trychlos/mysGarageDoors/build/mysGarageDoors.ods

Sheet: Nano
 |  |  | Digital | Analog |  | MySensors | NRF24L01 |  | Door n° 1 | Door n° 2
1 | TX | Reserved UART |  |  | PCINT2 Port D
2 | RX | Reserved UART
3 | RST
4 | GND |  |  |  |  |  | 1 | GND
5 | D2 / IRQ0 |  |  |  |  |  | 5 | IRQ | Opening move
6 | D3 / IRQ1 |  | √ |  |  |  |  |  | Closing move
7 | D4 |  | √ |  |  |  |  |  | Closed contact
8 | D5 |  | √ |  |  |  |  |  | Open/close button
9 | D6 |  | √ |  |  |  |  |  | Enabled
10 | D7 |  | √ |  |  | MY_RANDOMSEED_PIN
11 | D8 |  | √ |  | PCINT0 Port B
12 | D9 |  |  |  |  |  | 2 | CE
13 | D10 |  |  |  |  |  | 7 | CSN
14 | D11 |  |  |  |  |  | 6 | MOSI
15 | D12 |  |  |  |  |  | 4 | MISO
16 | D13 |  |  |  |  |  | 3 | SCK
17 | 3V3 |  |  |  |  |  | 8 | VCC
18 | AREF
19 | A0 |  | √ | √ | PCINT1 Port C |  |  |  | Learning program
20 | A1 |  | √ | √ |  |  |  |  |  | Enabled
21 | A2 |  | √ | √ |  |  |  |  |  | Open/close button
22 | A3 |  | √ | √ |  |  |  |  |  | Closed contact
23 | A4 |  | √ | √ |  |  |  |  |  | Closing move
24 | A5 |  | √ | √ |  |  |  |  |  | Opening move
25 | A6 |  |  | √
26 | A7 |  |  | √
27 | +5V
28 | RST
29 | GND
30 | VIN

Sheet: MySensors
Arduino sensor |  |  |  |  |  | mySensor event
Sens | Name | Id | Type | Comment | pwiSensor | Nature | Command | Message | Payload | Comment
In | CHILD_MAIN | 1 | S_CUSTOM | Main target |  | Action | C_REQ | V_CUSTOM | 1 | EEPROM reset
In | CHILD_MAIN | 1 | S_CUSTOM | Main target |  | Action | C_REQ | V_CUSTOM | 2 | Full configuration dump
In | CHILD_MAIN | 1 | S_CUSTOM | Main target |  | Action | C_REQ | V_CUSTOM | 3 | Run learning program
In | CHILD_MAIN+1 | 2 | S_CUSTOM | Main target |  | Action | C_SET | V_CUSTOM | <ms> | Set unchanged timeout (ms) ; default=3600000 (1h)
Out | CHILD_MAIN+1 | 2 | S_CUSTOM | Main target |  | Info |  | V_VAR1 | <ms> | Unchanged timeout
In | CHILD_MAIN+2 | 3 | S_CUSTOM | Main target |  | Action | C_SET | V_CUSTOM | <ms> | Set the reaction time of the sensors ; default=250ms
Out | CHILD_MAIN+2 | 3 | S_CUSTOM | Main target |  | Info |  | V_VAR1 | <ms> | Reaction time
In | CHILD_MAIN+3 | 4 | S_CUSTOM | Main target |  | Action | C_SET | V_CUSTOM | <ms> | Set the learning delay between open/close moves ; default=5000 (5s)
Out | CHILD_MAIN+3 | 4 | S_CUSTOM | Main target |  | Info |  | V_VAR1 | <ms> | Learning open/close delay
In | CHILD_MAIN+4 | 5 | S_CUSTOM | Main target |  | Action | C_SET | V_CUSTOM | <ms> | Set the learning delay each door moves ; default=5000 (5s)
Out | CHILD_MAIN+4 | 5 | S_CUSTOM | Main target |  | Info |  | V_VAR1 | <ms> | Learning inter-doors delay
In | CHILD_MAIN+5 | 6 | S_CUSTOM | Main target |  | Action | C_SET | V_CUSTOM | <ms> | Set the move debounce delay ; default=1000 (1s)
Out | CHILD_MAIN+5 | 6 | S_CUSTOM | Main target |  | Info |  | V_VAR1 | <ms> | Move debounce delay
In | CHILD_MAIN+6 | 7 | S_CUSTOM | Main target |  | Action | C_SET | V_CUSTOM | <ms> | Set the button push delay ; default=500ms
Out | CHILD_MAIN+6 | 7 | S_CUSTOM | Main target |  | Info |  | V_VAR1 | <ms> | Button push delay
In | CHILD_MAIN+7 | 8 | S_CUSTOM | Main target |  | Action | C_SET | V_CUSTOM | % | Set the minimal change to be published ; default=10%
Out | CHILD_MAIN+7 | 8 | S_CUSTOM | Main target |  | Info |  | V_VAR1 | % | Min published change
In | CHILD_ID_DOOR1 | 20 | S_DOOR |  |  | Action | C_REQ | V_CUSTOM | 1 | Open/close the door
Out | CHILD_ID_DOOR1 | 20 | S_DOOR |  |  | Info |  | V_VAR1 | 1|0 | Whether the door is enabled
Out | CHILD_ID_DOOR1+1 | 21 | S_DOOR |  |  | Info |  | V_UP | % | Whether the door is opening ; payload is position
Out | CHILD_ID_DOOR1+1 | 21 | S_DOOR |  |  | Info |  | V_DOWN | % | Whether the door is closing ; payload is position
Out | CHILD_ID_DOOR1+2 | 22 | S_DOOR |  |  | Info |  | V_PERCENTAGE | % | Door position (0=closed, 100=opened) – not sent during the move
Out | CHILD_ID_DOOR1+3 | 23 | S_DOOR |  |  | Info |  | V_VAR1 | 1|0 | 1 if door is fully closed (from the contact)
Out | CHILD_ID_DOOR1+4 | 24 | S_DOOR |  |  | Info |  | V_VAR1 | <ms> | Opening duration
Out | CHILD_ID_DOOR1+5 | 25 | S_DOOR |  |  | Info |  | V_VAR1 | <ms> | Closing duration
In | CHILD_ID_DOOR2 | 40 | S_DOOR |  |  | Action | C_REQ | V_CUSTOM | 1 | Open/close the door
Out | CHILD_ID_DOOR2 | 40 | S_DOOR |  |  | Info |  | V_VAR1 | 1|0 | Whether the door is enabled
