trychlos/mysGarageDoors/build/mysGarageDoors.sch

## KiCad design build/mysGarageDoors.sch (2019-11-02)

Schematic: mysGarageDoors.sch

Parts:
C1: 100nF
C2: 1000µF
D1, D2, D3, D4: 1N4004
D5, D6, D7, D8: LED
D9: D
K1, K2: MEDER_DIP05-1A72-12D
P1, P2, P3, P4, P5, P6, P7: CNX2
Q1, Q2, Q3, Q4: BS170; TO-92
R3, R6, R9, R12: 2,2k
R4, R5, R7, R8, R10, R11, R13, R14: 10k
R15, R16, R17, R18: 1k
SW1, SW2, SW3: SPST
U1: ArduinoNano
U2: NRF24L01
U3, U4: LTV-814; DIP-4

Notes on the sheet:
Door n° 2 Motor +/- 24v
2017-03-26
Door n° 1 Motor +/- 24v
A4-A5 / D2-D3 Au niveau haut au repos. Au niveau bas pendant le mouvement.
A3 / D4 - Contact binaire Au niveau haut si la porte est ouverte (même partiellement). Au niveau bas si la porte est fermée
Door n° 2 BP commande
Shorten to GND to disable the door
Door n° 1 BP commande
Contact door n° 2 is closed
Contact door n° 1 is closed
+8v / +11v from Door 2
Run learning program by pulsing A0 to LOW
