trychlos/mysGarageDoors/(commit log)

2017-04-28 mysGarageDoors: init repository
    [NanoConnections.ods, mysGarageDoors.sch, mysPowerS0.sch]
2017-04-28 Update Nano connections
    [NanoConnections.ods]
2017-04-30 First running version
    - position is not interpreted by jeedom
    - many messages during move
    [mysGarageDoors.sch]
2017-05-01 mysGarageDoors: code is OK
    [mysGarageDoors.sch]
2017-05-01 DoorClosed contact is managed via a Pullup resistor
    [mysGarageDoors.sch]
2017-05-14 Replace +24v VCC by 8-11v to VIN
    [mysGarageDoors.sch]
2019-11-02 Update schema and PCB
    [mysGarageDoors.sch]
2019-11-11 mysGarageDoors: full rewrite
    [NanoConnections.ods]
2019-11-11 mysGarageDoors: add commands sheet
    [mysGarageDoors.ods]
