trychlos/mysGarageDoors/(notices)

Notices in the files:
mysGarageDoors.ino:
modify it under the terms of the GNU General Public License
